trilithus/protogasm/case/stl/protogasm_lid.stl

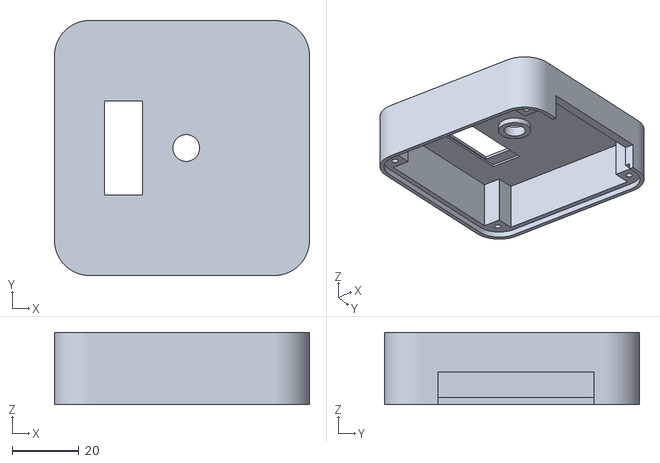
[picture p1: CAD file, 2022-07-20]
case/stl/protogasm_lid.stl
76.3 x 76.3 x 21.7
