trilithus/protogasm/case/stl/protogasm_param.stl

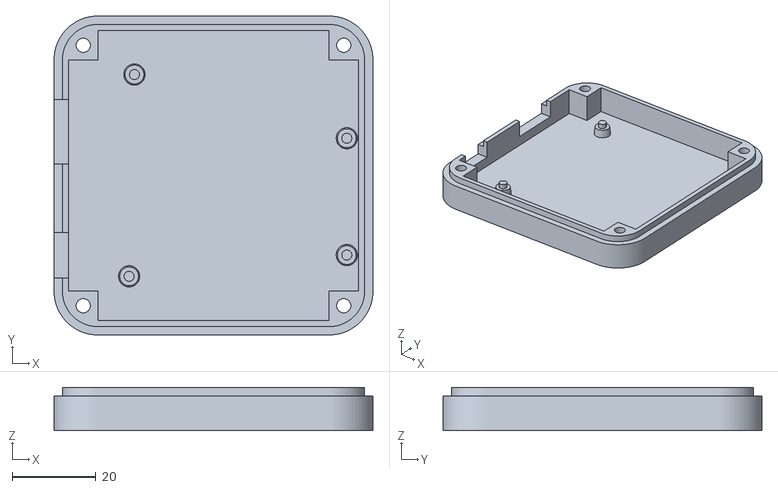
[picture p2: CAD file, 2022-07-20]
case/stl/protogasm_param.stl
76.3 x 76.3 x 10.3
