trilithus/protogasm/case/stl/dummy_base.stl

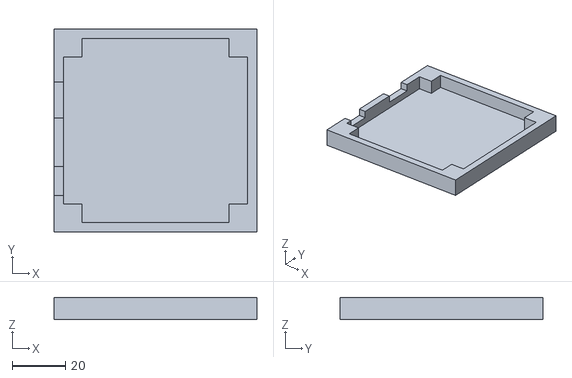
[picture p3: CAD file, 2022-07-20]
case/stl/dummy_base.stl
76.3 x 76.3 x 8.30
