trilithus/protogasm/case/openscad/protogasm_base.scad

//  ----------------------------------------------------------------------- LICENSE
//  This "3D Printed Case for Arduino Uno, Leonardo" by Zygmunt Wojcik is licensed
//  under the Creative Commons Attribution-ShareAlike 3.0 Unported License.
//  To view a copy of this license, visit
//  http://creativecommons.org/licenses/by-sa/3.0/
//  or send a letter to Creative Commons, PO Box 1866, Mountain View, CA 94042, USA.


include <protogasm_param.scad>
is_dummy = false;
usbHolePosition=38.1 + 3 - 0.5;
usbHeight=10.8 + 2;
usbWide=11.43 + 5;
powerJackPosition=7.62;
powerJackWide=8.9 +2;
powerJackHeight=10.8 +2;

//------------------------------------------------------------------------- MODULES
module pcbLeg() {		
	translate([0, 0, 0])
	difference() {
        if (!is_dummy)
        {
            cylinder(h = floorHeight + pcbPositionZ, r1=5.5/2, r2 = 4.5/2);
        }
	}
}


//------------------------------------------------------------------------- MAIN BLOCK
rotate([0,0,180])
translate([0,0,(-height/2)+blockLockSize])
difference()
{
																		// ADD
	union()
	{       
        if (!is_dummy)
        {
            linear_extrude(height = height/2, convexity = 10)
            
            // Add Base
            minkowski()
            {									
                square([width, wide], center = true);
                circle(roundR);
            }      
        }
        else
        {
            translate([0,0,height/4])
            cube([width+(roundR*2), wide + (2*roundR), height/2], true);
        }
	}
    
	// SUBSTRACT
	union()
	{
		// Lift floor height
		translate([0, 0, floorHeight])
		{
			// Cut Base hole
			linear_extrude(height = height/2, convexity = 10)
			minkowski()
			{
				square([width, wide], center = true);
				circle(roundR - pillarSize);
			}
            
			// Cut upper block lock
            
			difference() {
                
				translate([0, 0, height/2 - floorHeight - blockLockSize]) {
					cylinder(h = blockLockSize+gap, r=width);
				}
				translate([0, 0, height/2 - floorHeight - blockLockSize - gap*2]) {
                    if (!is_dummy)
                    {
                        r = roundR - (layerWidth*4);
                        linear_extrude(height = blockLockSize+gap*4, convexity = 10)
                        minkowski() {
                            square([width, wide], center=true);
                            r = roundR - layerWidth*4;
                            circle(r);
                        } 
                    }
				}
			}
            
			// Cut x panels 
			for (i = [0 : 180 : 180])				
			rotate([0, 0, i])
			translate([width/2 + roundR - pillarSize/2 - layerWidth*7, 0, 0])
			{
				// Cut X panel hole
				translate([0, 0, height/2])
				cube([pillarSize, sidePanelXWidth, height], center=true);
                if (!is_dummy)
                {
                    // Cut X, Y srew holes
                    for (i = [wide/2, -wide/2])
                    {
                        translate([-(roundR - pillarSize/2 - layerWidth*7), i, - floorHeight])
                        if (i>0) 
                        {
                            rotate([0, 0, 45])
                            translate([screwHoleRoundR, 0, 0])
                            {
                                cylinder(h = height*2, r=screwExt/2, center=true);
                                cylinder(h = 5,
                                        r1 = (screwHead + (screwHead - screwExt))/2,
                                        r2 = screwExt/2, center=true);
                            }
                        }
                        else
                        {
                            rotate([0, 0, -45])
                            translate([screwHoleRoundR, 0, 0])
                            {
                                cylinder(h = height*2, r=screwExt/2, center=true);
                                cylinder(h = 5,
                                        r1 = (screwHead + (screwHead - screwExt))/2,
                                        r2 = screwExt/2, center=true);
                            }
                        }
                    }
                }
			}
            
			// Cut Y panels 
			for (i = [90 : 180 : 270])
			rotate([0, 0, i])
			translate([wide/2 + roundR - pillarSize/2 - layerWidth*7, 0, 0])
			{
				// Cut Y panel hole
				translate([0, 0, height/2])
				cube([pillarSize, sidePanelYWidth, height], center=true);
			}
			
            // Cut USB and Power holes
			// translate to pcb position
			translate([-pcbPositionX, -pcbWide/2, pcbPositionZ + pcbHeight])
			{
				// cut power hole
				translate([0, powerJackPosition+10, (powerJackHeight-2)/2])
				cube([10, powerJackWide+20, powerJackHeight], center=true);
				
                // cut usb hole
				translate([0, usbHolePosition, (usbHeight-2)/2])
				cube([10, usbWide, usbHeight], center=true);
			}
		}
	}
}

//------------------------------------------------------------------------- ADD PCB LEGS
// Translate to pcbPositionX	
rotate([0,0,180])
translate([0,0,(-height/2)+blockLockSize])
translate([-pcbPositionX, -pcbWide/2, 0])
difference()
{
																		// ADD
	union()
	{
        if (!is_dummy)
        {
            // Add pcb legs
            for(i=[ [13.97, 2.54, 0], 				
                    [15.24, 50.8, 0],
                    [66.04, 35.56, 0],
                    [66.04, 7.62, 0] ])
            {
                    translate(i)
                    pcbLeg();
            }
        
            // Add pcb holders
            for(i=[ [13.97, 2.54, 0],
                    [15.24, 50.8, 0],
                    [66.04, 35.56, 0],
                    [66.04, 7.62, 0] ])
            {
                translate(i)
                cylinder(h=floorHeight+pcbPositionZ+1.5, r=1.2);
            }
        }
	}
																		// SUBSTRACT
	union()
	{
		//
	}
}
