trilithus/protogasm/(list of files, cad)

Other CAD files:
case/stl/base.stl
case/stl/lid.stl
case/stl/dummy_lid.stl
case/openscad/protogasm_lid.scad
