trilithus/protogasm/pcb/protogasm.brd

## EAGLE design pcb/protogasm.brd (2021-11-07)

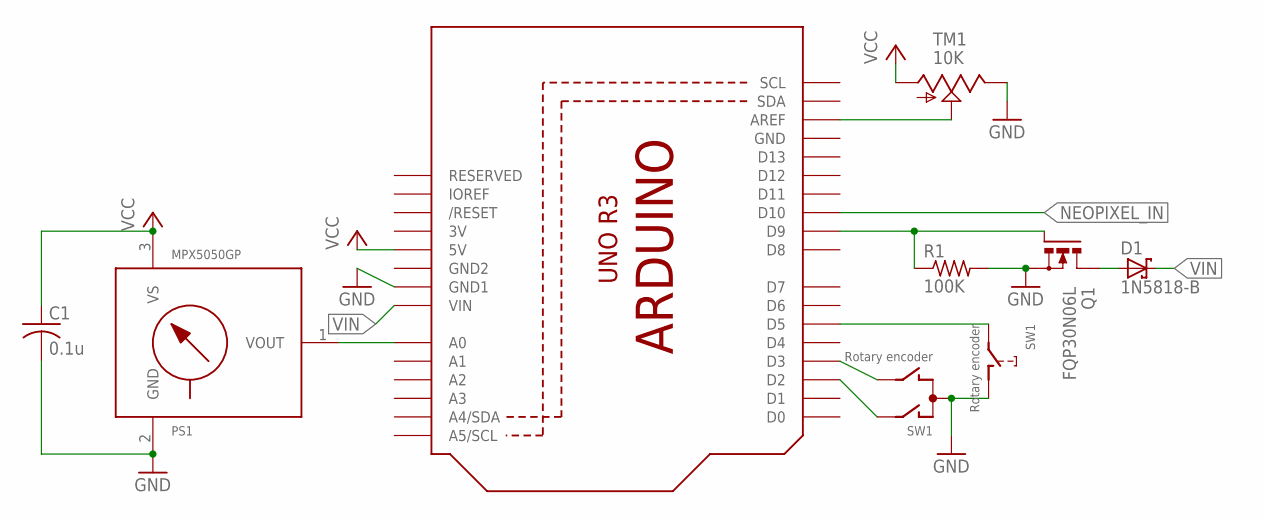
[picture p4: schematic protogasm.sch]

Parts:
C1: 0.1u; C025-025X050
D1: 1N5818-B; DO41-7.6
PS1: MPX5050GP; 867B-H
Q1: FQP30N06L; TO220BH
R1: 100K; 0207/10
SW1: Rotary encoder; ALPS_EC12E_SW
TM1: 10K; 6MM
U1: ARDUINOR3PERF; PERF

Connections:
3V: U1.3V, U1.3V. (3V)
GND: C1.2, PS1.2 (GND), Q1.S, R1.2, SW1.C, SW1.D (1), TM1.E, U1.GND, U1.GND1, U1.GND1. (GND1), U1.GND. (GND)
GND2: U1.GND2, U1.GND2. (GND2)
unnamed: SW1.A, U1.D2, U1.D2. (D2)
unnamed: SW1.B, U1.D3, U1.D3. (D3)
unnamed: SW1.E (2), U1.D5, U1.D5. (D5)
unnamed: TM1.S, U1.AREF, U1.AREF. (AREF)
unnamed: Q1.G, R1.1, U1.D9, U1.D9. (D9)
unnamed: D1.A, Q1.D
unnamed: PS1.1 (VOUT), U1.A0, U1.A0. (A0)
NEOPIXEL_IN: U1.D10, U1.D10. (D10)
VCC: C1.1, PS1.3 (VS), TM1.A, U1.5V, U1.5V. (5V)
VIN: D1.C, U1.VIN, U1.VIN. (VIN)

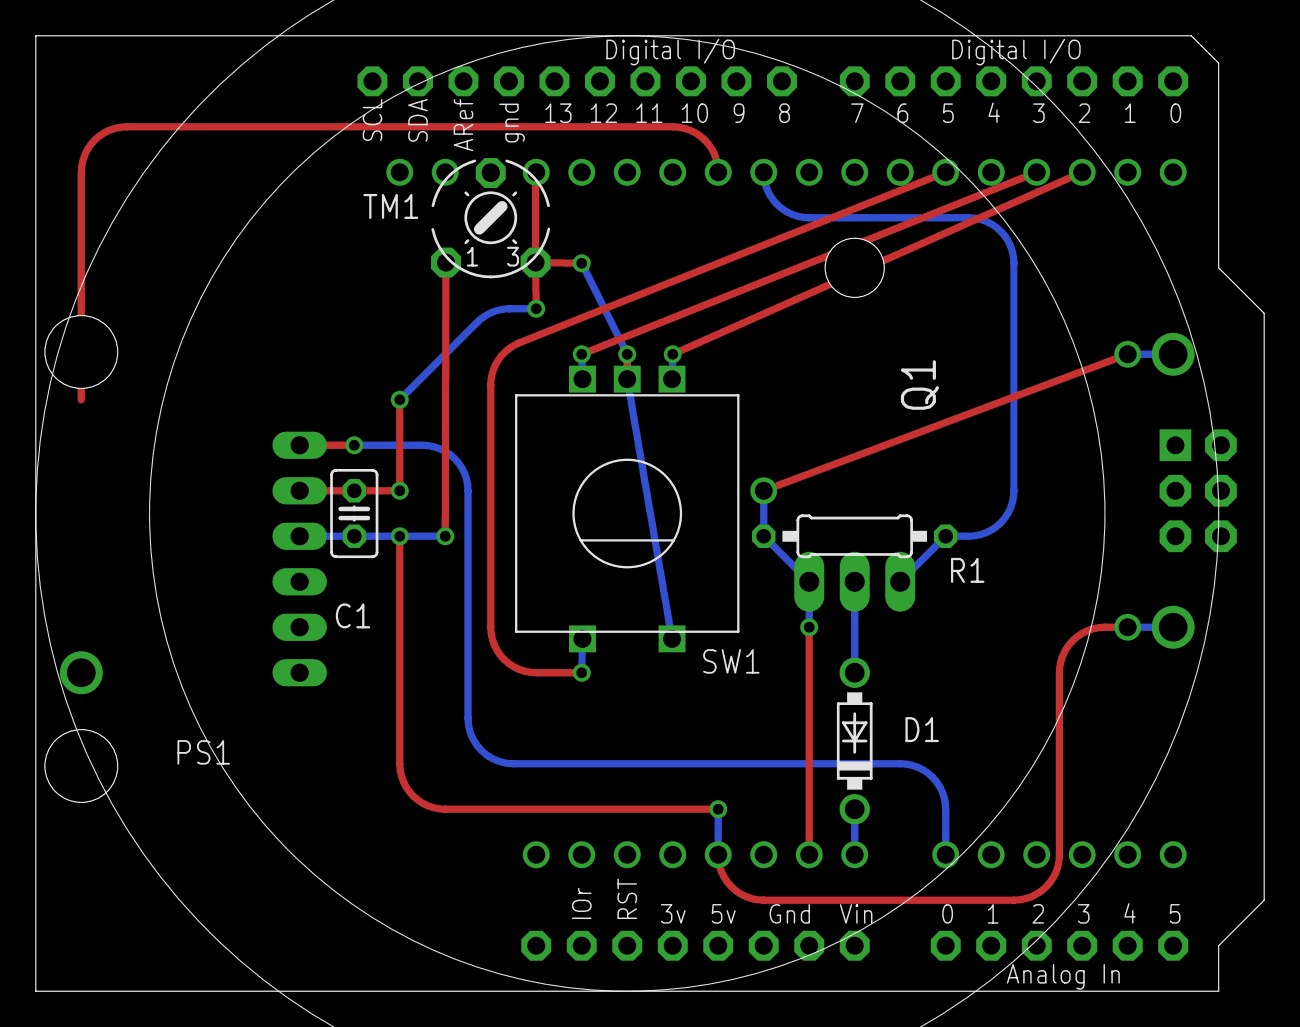
[picture p5: board protogasm.brd from above]

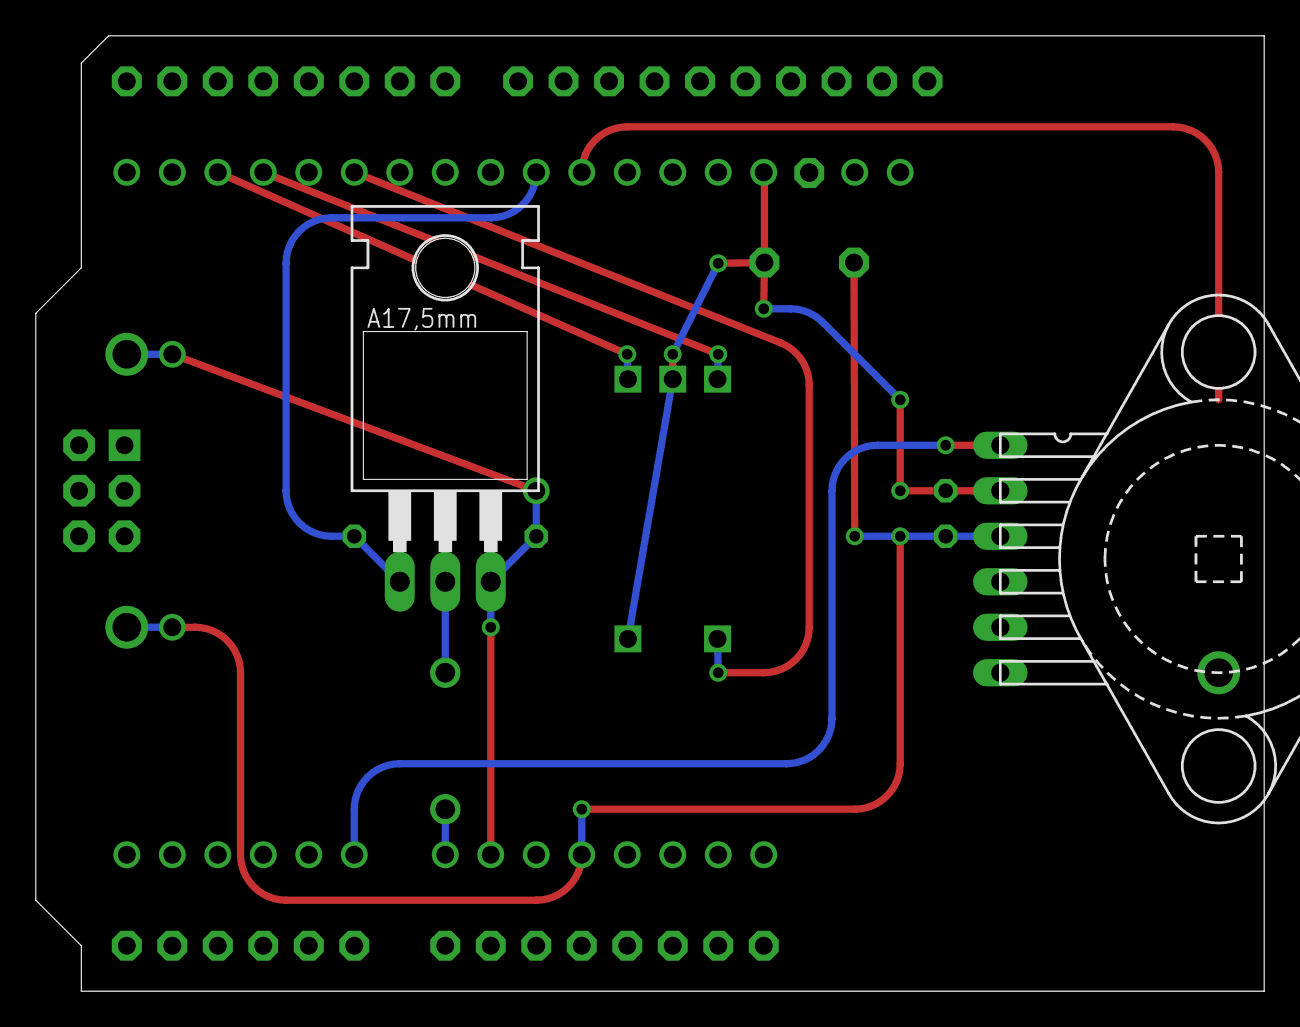
[picture p6: board protogasm.brd from below]

Board: 2 copper layers, 68.6 x 53.3 mm, 8 parts (2 on the bottom side), 13 nets.
