trilithus/protogasm/(commit log)

2021-11-07 Add note to modify pressure sensor
    closes #4
2021-11-07 Corrected value of R1 to 100K
    The value isn't critical, but it should be consistent. Change it to
    100K to match the BOM.
    I have also added the EAGLE sources so they can be versioned too.
    closes #1
    [protogasm.brd, protogasm.sch]
2021-11-07 Fix part number in BOM for encoder SW1
    The EC12E series does not have a push switch, despite what the EAGLE
    libraries think. BOM updated to reference the EC12D instead. The
    schematic and layout images were already updated in commit
    fbefd36e2d957bc667f40ca047ca02a24aec2fde . The existing Mouser and
    Amazon links should still provide the correct parts.
    closes #3
2021-12-09 Several hacks to the protogasm/nogasm code: * Added LCD screen (https://www.az-delivery.de/en/products/0-91-zoll-i2c-oled-display?variant=6127765094427) * Increased ramptime to 1m * Replaced custom v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
    [nogasm_code.ino]
2021-12-13 Refactored code, added pin defines.
2021-12-13 Setting up additional logger device (esp8266 connected via I2C)
2021-12-14 Added commandmanager for handling i2c communication (later)
2021-12-14 Implemented coroutines since pulsing the magic wand buttons takes 100s of ms.
2021-12-17 Hacked in I2C communication to logger slave
2021-12-18 WIP - lid modifications
    [protogasm_base.scad, protogasm_lid.scad, protogasm_param.scad]
2022-01-11 Modified case to have a little bit more space.
    [protogasm_base.scad, protogasm_lid.scad]
2022-04-23 * fixed bug in motor speed settings, where cycling down could be aborted and cause the state to be incorrectly assumed. * tweaked average and limit settings
    [nogasm_code.ino]
2022-07-20 FIX - Speed will reset to 0 after edges (meaning that it will - more times than neccesary in case we overshot)
    [nogasm_code.ino]
2022-07-20 Modified case files
    [base.stl, dummy_base.stl, dummy_lid.stl, lid.stl, protogasm_lid.stl, protogasm_param.stl]
2022-08-31 Various changes. * Modified logger command to send a bytestream instead of a string, to log as CSV * Fixed issue where session start/stop was not properly sent (was commented out). * Fixed issue wher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
    [csvlogcommand.h, nogasm_code.ino, sharedcommands.h]
2022-12-16 Avg Pressure is no longer updated during the edging period, only during rest.
    [nogasm_code.ino]
2023-09-17 Port to Arduino Uno R4 Wifi
